hatlabs/HALPI2-hardware/CHANGES.txt

# Changes to the Covered Sources

## Introduction

As per CERN-OHL-S v2 subsection 3.3 (b), you must describe changes made to the
Covered Sources. This file is intended to be used for that purpose.

Use this file to include notices stating that you have modified the hardware
designs, giving a date and information about the modifications you have
made.

## List of Changes

- 2025-01-26: The original HALPI2 hardware design. You may replace this
  entry as it only serves as an example. [Matti Airas / Hat Labs Oy]
