hatlabs/HALPI2-hardware/(commit log)

2025-01-06 Squash history into a single commit
    [Audio.kicad_sch, CM4.kicad_sch, CM4_GPIO.kicad_sch, CM4_HS.kicad_sch, ControlRTC.kicad_sch, Ethernet.kicad_sch, PCIe.kicad_sch, PoE.kicad_sch]
2025-01-06 Weeded out all ERC errors
    [CM4_GPIO.kicad_sch, CM4_HS.kicad_sch, ControlRTC.kicad_sch, Ethernet.kicad_sch, HALPI2.kicad_sch, PCIe.kicad_sch, PoE.kicad_sch, Power.kicad_sch]
2025-01-06 Implement ideal diodes for input and LDO power ORing
    [CM4_GPIO.kicad_sch, CM4_HS.kicad_sch, HALPI2.kicad_sch, PCIe.kicad_sch, PoE.kicad_sch, Power.kicad_sch, SDCard.kicad_sch, USB.kicad_sch]
2025-01-06 Re-annotate schematics
    [CM4_GPIO.kicad_sch, CM4_HS.kicad_sch, ControlRTC.kicad_sch, Ethernet.kicad_sch, PCIe.kicad_sch, PoE.kicad_sch, Power.kicad_sch, SDCard.kicad_sch]
2025-01-06 Sprinkle test points on the schematics
    [CM4_GPIO.kicad_sch, CM4_HS.kicad_sch, ControlRTC.kicad_sch, Ethernet.kicad_sch, PCIe.kicad_sch, PoE.kicad_sch, Power.kicad_sch, SDCard.kicad_sch]
2025-01-06 Revert USB3 ports back to Type A
    [USB3.kicad_sch, rs485.kicad_sch]
2025-01-08 Fix ethernet port & other changes
    [CM4_HS.kicad_sch, Ethernet.kicad_sch, SDCard.kicad_sch, USB.kicad_sch, USB3.kicad_sch, can.kicad_sch, protection.kicad_sch]
2025-01-08 Reserve USB 2 for peripheral use only
    [USB.kicad_sch]
2025-01-10 Implement a USB3 hub
    [Audio.kicad_sch, CM4_GPIO.kicad_sch, CM4_HS.kicad_sch, ControlRTC.kicad_sch, Ethernet.kicad_sch, HALPI2.kicad_sch, PCIe.kicad_sch, PoE.kicad_sch]
2025-01-10 Finish component selection for USB3 hub
    [PoE.kicad_sch, USB3.kicad_sch, can.kicad_sch, idc.kicad_sch, pcb.kicad_sch, protection.kicad_sch, usb3_hub.kicad_sch, usb3if.kicad_sch]
2025-01-16 Partial trace layout, kick-ass custom rules
    [CM4_GPIO.kicad_sch, CM4_HS.kicad_sch, ControlRTC.kicad_sch, Ethernet.kicad_sch, HALPI2.kicad_sch, PCIe.kicad_sch, PoE.kicad_sch, Power.kicad_sch]
2025-01-16 Remove PoE support
    [Ethernet.kicad_sch, HALPI2.kicad_sch]
2025-01-18 Move to a two-sided assembly
    [Ethernet.kicad_sch, buck_10V.kicad_sch, buck_3.3V.kicad_sch, buck_5V.kicad_sch, protection.kicad_sch, supercap_stage.kicad_sch, usb3_hub.kicad_sch, usb3if.kicad_sch]
2025-01-24 A big part of layout and routing done
    [CM4_GPIO.kicad_sch, CM4_HS.kicad_sch, Ethernet.kicad_sch, HALPI2.kicad_sch, PCIe.kicad_sch, Power.kicad_sch, SDCard.kicad_sch, USB2.kicad_sch]
2025-01-26 Route more traces
    [CM4_GPIO.kicad_sch, CM4_HS.kicad_sch, Ethernet.kicad_sch, HALPI2.kicad_sch, PCIe.kicad_sch, USB2.kicad_sch, can.kicad_sch, control_mcu.kicad_sch]
2025-01-26 Update the license text and provide CHANGES.txt
    As all contents of Nabu Casa Yellow have been substituted with
    original designs or designs originating from the Raspberry Pi
    reference designs, their license notices have been removed.
2025-01-26 Fix license statements in documents
    [CM4_GPIO.kicad_sch, CM4_HS.kicad_sch, Ethernet.kicad_sch, HALPI2.kicad_sch, PCIe.kicad_sch, Power.kicad_sch, SDCard.kicad_sch, USB2.kicad_sch]
2025-01-26 Traces routed
    [CM4_GPIO.kicad_sch, Ethernet.kicad_sch, control_mcu.kicad_sch]
2025-01-26 Fix schematic ERC errors
    [CM4_GPIO.kicad_sch, CM4_HS.kicad_sch, Ethernet.kicad_sch, HALPI2.kicad_sch, PCIe.kicad_sch, Power.kicad_sch, SDCard.kicad_sch, USB2.kicad_sch]
2025-01-27 Fix footprint courtyard
2025-01-27 Renumber all sheets
    [CM4_GPIO.kicad_sch, CM4_HS.kicad_sch, Ethernet.kicad_sch, HALPI2.kicad_sch, USB2.kicad_sch, USB3.kicad_sch, can.kicad_sch, control_mcu.kicad_sch]
2025-01-27 Reannotate components
    [CM4_GPIO.kicad_sch, CM4_HS.kicad_sch, Ethernet.kicad_sch, PCIe.kicad_sch, Power.kicad_sch, SDCard.kicad_sch, USB2.kicad_sch, USB3.kicad_sch]
2025-02-02 Most DRC errors fixed
    [CM4_GPIO.kicad_sch, CM4_HS.kicad_sch, Ethernet.kicad_sch, HALPI2.kicad_sch, USB2.kicad_sch, buck_10V.kicad_sch, buck_10V_ic.kicad_sch, buck_3.3V.kicad_sch]
2025-02-06 Fix most DRC errors, partial silk screen
    [CM4_GPIO.kicad_sch, CM4_HS.kicad_sch, Ethernet.kicad_sch, USB2.kicad_sch, buck_10V.kicad_sch, can.kicad_sch, control_mcu.kicad_sch, dphy.kicad_sch]
2025-02-08 Silkscreen mostly done
    [CM4_GPIO.kicad_sch, CM4_HS.kicad_sch, Ethernet.kicad_sch, PCIe.kicad_sch, SDCard.kicad_sch, USB2.kicad_sch, USB3.kicad_sch, buck_3.3V.kicad_sch]
2025-02-15 Finish the board redesign with SoM on the bottom
    [CM4_GPIO.kicad_sch, CM4_HS.kicad_sch, Ethernet.kicad_sch, HALPI2.kicad_sch, PCIe.kicad_sch, Power.kicad_sch, SDCard.kicad_sch, USB2.kicad_sch]
2025-02-20 Further refinements
    [CM4_GPIO.kicad_sch, CM4_HS.kicad_sch, Ethernet.kicad_sch, HALPI2.kicad_sch, PCIe.kicad_sch, Power.kicad_sch, SDCard.kicad_sch, USB2.kicad_sch]
2025-02-22 Change MCU to RP2040
    [CM4_GPIO.kicad_sch, CM4_HS.kicad_sch, Ethernet.kicad_sch, HALPI2.kicad_sch, Power.kicad_sch, USB2.kicad_sch, USB3.kicad_sch, can.kicad_sch]
2025-02-24 Finish transitioning to RP2040
    [CM4_GPIO.kicad_sch, CM4_HS.kicad_sch, Ethernet.kicad_sch, HALPI2.kicad_sch, PCIe.kicad_sch, Power.kicad_sch, SDCard.kicad_sch, USB2.kicad_sch]
2025-02-24 Remove stale files
    [ldo_3.3V.kicad_sch, ldo_3v3.kicad_sch]
2025-02-25 Apply part PCBA position corrections
    [CM4_GPIO.kicad_sch, CM4_HS.kicad_sch, Ethernet.kicad_sch, Power.kicad_sch, SDCard.kicad_sch, USB2.kicad_sch, USB3.kicad_sch, buck_10V.kicad_sch]
2025-02-26 Apply teardrops, add vias around PCIe connector, update title blocks
    [CM4_GPIO.kicad_sch, CM4_HS.kicad_sch, Ethernet.kicad_sch, HALPI2.kicad_sch, PCIe.kicad_sch, Power.kicad_sch, SDCard.kicad_sch, USB2.kicad_sch]
2025-03-26 Fix battery connector polarity
2025-03-26 Use new supplier enclosure outline
    [pcb.kicad_sch]
2025-03-26 Increase USB3 nEN pulldown resistor size
    [usb3if.kicad_sch]
2025-03-26 Re-add test fixture annotations to layout
    [CM4_GPIO.kicad_sch, CM4_HS.kicad_sch, Ethernet.kicad_sch, USB2.kicad_sch, can.kicad_sch, control_mcu.kicad_sch, rs485.kicad_sch, rtc.kicad_sch]
2025-04-01 Update the design to match the enclosure changes
    [CM4_GPIO.kicad_sch, CM4_HS.kicad_sch, Ethernet.kicad_sch, HALPI2.kicad_sch, PCIe.kicad_sch, Power.kicad_sch, SDCard.kicad_sch, USB2.kicad_sch]
2025-04-01 Update CM connector part number
    [CM4_GPIO.kicad_sch, CM4_HS.kicad_sch]
2025-04-01 Add comments about diff pair polarity
    [PCIe.kicad_sch, dphy.kicad_sch, hdmi.kicad_sch, usb3_hub.kicad_sch]
2025-04-02 Update SiC462 datasheet
    [CM4_GPIO.kicad_sch, CM4_HS.kicad_sch, Ethernet.kicad_sch, USB2.kicad_sch, buck_10V_ic.kicad_sch, can.kicad_sch, control_mcu.kicad_sch, rs485.kicad_sch]
2025-04-04 Update buck components according to testing results
    [buck_10V_ic.kicad_sch]
2025-04-04 Update current limiter components
    [current_limiter.kicad_sch]
2025-04-04 Implement overvoltage disconnect
    [protection.kicad_sch]
2025-04-10 Get the buck EN input from VIN_OVP
    [buck_10V.kicad_sch, buck_10V_ic.kicad_sch]
2025-04-10 Update CAN transceiver value to match the used parts; connect VIO
    [can.kicad_sch]
2025-04-10 Remove CM4 fan provisions
    [CM4_GPIO.kicad_sch]
2025-04-10 Replace DPHY selector jumper with a slide switch
    [CM4_HS.kicad_sch]
2025-04-10 Reorder MCU inputs to help routing on the board top side
    [control_mcu.kicad_sch]
2025-04-10 Fix DPHY pinout
    [dphy.kicad_sch]
2025-04-10 Try to improve current limiter stability
    [current_limiter.kicad_sch]
2025-04-10 Remove Molex fan connector, add another CM5 connector to board bottom
    [fan_connectors.kicad_sch]
2025-04-10 Fix HDMI pinout
    [hdmi.kicad_sch]
2025-04-10 Move battery holder footprint to global library
2025-04-10 Fixme VIN_OVP
    [Power.kicad_sch]
2025-04-10 Use LM74800 for input protection
    [protection.kicad_sch]
2025-04-10 Remove the CM4 RTC IC
    [control_mcu.kicad_sch, rtc.kicad_sch]
2025-04-10 Reannotate the board
    [CM4_GPIO.kicad_sch, CM4_HS.kicad_sch, Ethernet.kicad_sch, HALPI2.kicad_sch, PCIe.kicad_sch, SDCard.kicad_sch, USB2.kicad_sch, USB3.kicad_sch]
2025-04-13 Fix DRC issues
    [CM4_GPIO.kicad_sch, CM4_HS.kicad_sch, Ethernet.kicad_sch, PCIe.kicad_sch, Power.kicad_sch, SDCard.kicad_sch, USB2.kicad_sch, USB3.kicad_sch]
2025-04-15 Add GND/3.3V/5V headers, add missing JLC part numbers
    [CM4_GPIO.kicad_sch, CM4_HS.kicad_sch, Ethernet.kicad_sch, buck_10V.kicad_sch, buck_10V_ic.kicad_sch, buck_3.3V.kicad_sch, buck_5V.kicad_sch, can.kicad_sch]
2025-04-15 Adjust Micro-USB 5V LDO layout
    Diode before LDO, not after
    [control_mcu.kicad_sch]
2025-04-15 Adjust 10V buck design based on Vishay tool output
    [HALPI2.kicad_sch, Power.kicad_sch, buck_10V.kicad_sch, buck_10V_ic.kicad_sch, control_mcu.kicad_sch]
2025-04-25 FInal v0.2.0 proto changes
    [CM4_GPIO.kicad_sch, CM4_HS.kicad_sch, Ethernet.kicad_sch, PCIe.kicad_sch, SDCard.kicad_sch, USB2.kicad_sch, USB3.kicad_sch, buck_10V.kicad_sch]
2025-04-25 Add reverse current blocking to 3.3V buck output
    [CM4_GPIO.kicad_sch, CM4_HS.kicad_sch, Ethernet.kicad_sch, PCIe.kicad_sch, Power.kicad_sch, SDCard.kicad_sch, USB2.kicad_sch, USB3.kicad_sch]
2025-05-01 Fix HDMI and DSI pinouts, again
    Also add the missing LM74800 diode
    [CM4_GPIO.kicad_sch, CM4_HS.kicad_sch, Ethernet.kicad_sch, USB2.kicad_sch, can.kicad_sch, control_mcu.kicad_sch, protection.kicad_sch, rs485.kicad_sch]
2025-05-06 Nailed the current limiter design
    Also added more GND test pads
    Also fixed the MCU I2C pinout
    [CM4_GPIO.kicad_sch, CM4_HS.kicad_sch, Ethernet.kicad_sch, PCIe.kicad_sch, Power.kicad_sch, SDCard.kicad_sch, USB2.kicad_sch, USB3.kicad_sch]
2025-05-06 Add a THT testpoint for Vscap
    [CM4_GPIO.kicad_sch, CM4_HS.kicad_sch, Ethernet.kicad_sch, USB2.kicad_sch, can.kicad_sch, control_mcu.kicad_sch, dphy.kicad_sch, rs485.kicad_sch]
2025-05-07 Optimize 10V buck converter based on testing
    [buck_10V_ic.kicad_sch, current_limiter.kicad_sch]
2025-05-07 Remove unnecessary pullup
    [buck_3.3V.kicad_sch]
2025-05-07 Connect PCIe LED to MCU
    [CM4_GPIO.kicad_sch, CM4_HS.kicad_sch, Ethernet.kicad_sch, HALPI2.kicad_sch, PCIe.kicad_sch, USB2.kicad_sch, can.kicad_sch, control_mcu.kicad_sch]
2025-05-08 Final chores
    - Reannotate components
    - Improve USB2 connector skew matching
    - Update sheet blocks
    - Fix some diff-pair double-inversions
    [CM4_GPIO.kicad_sch, CM4_HS.kicad_sch, Ethernet.kicad_sch, HALPI2.kicad_sch, PCIe.kicad_sch, Power.kicad_sch, SDCard.kicad_sch, USB2.kicad_sch]
2025-05-08 Add some missing LCSC P/Ns
    [CM4_GPIO.kicad_sch, CM4_HS.kicad_sch, Ethernet.kicad_sch, PCIe.kicad_sch, Power.kicad_sch, SDCard.kicad_sch, USB2.kicad_sch, USB3.kicad_sch]
2025-05-08 Add some vias to appease breakneck
    [CM4_GPIO.kicad_sch, CM4_HS.kicad_sch, Ethernet.kicad_sch, PCIe.kicad_sch, Power.kicad_sch, SDCard.kicad_sch, USB2.kicad_sch, USB3.kicad_sch]
2025-06-05 Fix DSI/CSI connector orientation
2025-06-06 Move DPHY conx on top of the CM5
    [CM4_GPIO.kicad_sch, CM4_HS.kicad_sch, Ethernet.kicad_sch, PCIe.kicad_sch, Power.kicad_sch, SDCard.kicad_sch, USB2.kicad_sch, USB3.kicad_sch]
2025-06-06 Bump version, adjust silkscreen
    [CM4_GPIO.kicad_sch, CM4_HS.kicad_sch, Ethernet.kicad_sch, HALPI2.kicad_sch, PCIe.kicad_sch, Power.kicad_sch, SDCard.kicad_sch, USB2.kicad_sch]
2025-06-06 Prepare v0.4.0 release
    [CM4_GPIO.kicad_sch, CM4_HS.kicad_sch, Ethernet.kicad_sch, USB2.kicad_sch, buck_3.3V.kicad_sch, can.kicad_sch, control_mcu.kicad_sch, dphy.kicad_sch]
2025-06-09 Improve 10V buck stability
    Also use a different net for Iin ADC input, add a 3.3V UVLO and
    a slow reset for the MCU.
    [CM4_GPIO.kicad_sch, CM4_HS.kicad_sch, Ethernet.kicad_sch, HALPI2.kicad_sch, PCIe.kicad_sch, Power.kicad_sch, SDCard.kicad_sch, USB2.kicad_sch]
2025-06-18 Increase RP2040 decoupling capacitance
    [CM4_GPIO.kicad_sch, CM4_HS.kicad_sch, Ethernet.kicad_sch, USB2.kicad_sch, buck_3.3V.kicad_sch, can.kicad_sch, control_mcu.kicad_sch, dphy.kicad_sch]
2025-06-26 Silkscreen fix
2025-06-26 Use SPI legacy pin names
    SDI and SDO were ambiguous.
    [CM4_GPIO.kicad_sch, CM4_HS.kicad_sch, Ethernet.kicad_sch, PCIe.kicad_sch, Power.kicad_sch, SDCard.kicad_sch, USB2.kicad_sch, USB3.kicad_sch]
2025-07-03 Remove copper pour from bottom layer next to mounting structures
2025-07-03 Fix 3.3V buck UVLO top resistor
    [CM4_GPIO.kicad_sch, CM4_HS.kicad_sch, Ethernet.kicad_sch, USB2.kicad_sch, buck_3.3V.kicad_sch, can.kicad_sch, control_mcu.kicad_sch, dphy.kicad_sch]
2025-07-03 Remove THTs from HAT outline footprint
2025-07-03 Add solder nuts to schema
    [pcb.kicad_sch]
2025-07-28 Change two-pin headers back to THT for mechanical durability
    Also fix a silk screen issue and move the 3.3V off header to a better
    position.
    [CM4_GPIO.kicad_sch, CM4_HS.kicad_sch, Ethernet.kicad_sch, USB2.kicad_sch, can.kicad_sch, control_mcu.kicad_sch, current_limiter.kicad_sch, dphy.kicad_sch]
2025-07-30 Add solder nuts to CM5 mounting holes
    Also revert two-pin headers back to THT type for better mechanical
    durability. Remove unused symbol fields. Move the 3.3V off pin to
    a more accessible location.
    [CM4_GPIO.kicad_sch, CM4_HS.kicad_sch, Ethernet.kicad_sch, PCIe.kicad_sch, Power.kicad_sch, SDCard.kicad_sch, USB2.kicad_sch, USB3.kicad_sch]
2025-08-03 Derive VinS from VIN_OVP
    Some extra care needed for routing due to a split ground.
    [HALPI2.kicad_sch, Power.kicad_sch, control_mcu.kicad_sch]
2025-08-09 Decrease Iin ADC series resistor to 1kohm
    [control_mcu.kicad_sch]
2025-08-09 Bump the board version
    [CM4_GPIO.kicad_sch, CM4_HS.kicad_sch, Ethernet.kicad_sch, HALPI2.kicad_sch, PCIe.kicad_sch, Power.kicad_sch, SDCard.kicad_sch, USB2.kicad_sch]
2025-08-12 WIP supercap balancer
    [supercap_stage.kicad_sch]
2025-08-12 Also derive VscapE from 3.3V early LDO
    [early_3v3.kicad_sch]
2025-08-12 Add a +5V LED
    [mcu_leds.kicad_sch]
2025-08-12 Adjust the supercap balancer components
    The opamps are now powered using VscapE
    [Power.kicad_sch, supercap.kicad_sch, supercap_stage.kicad_sch]
2025-08-13 Belt and suspenders: add a pull-down resistor footprint to balancer op-amp output
    [HALPI2.kicad_sch, supercap_stage.kicad_sch]
2025-08-13 Reorganize the forced power and MCU boot headers
    [HALPI2.kicad_sch, Power.kicad_sch, buck_3.3V.kicad_sch, buck_5V.kicad_sch, control_mcu.kicad_sch]
2025-08-15 Bump the title block date
    [CM4_GPIO.kicad_sch, CM4_HS.kicad_sch, Ethernet.kicad_sch, HALPI2.kicad_sch, PCIe.kicad_sch, Power.kicad_sch, SDCard.kicad_sch, USB2.kicad_sch]
2025-08-15 Add missing part codes
    [control_mcu.kicad_sch, supercap_stage.kicad_sch]
2025-08-15 Add missing JLCPCB orientation correction fields
    [can.kicad_sch, control_mcu.kicad_sch, rs485.kicad_sch]
2025-08-18 Change the 10V buck to SiC563
    [buck_10V_ic.kicad_sch]
2025-08-24 Move the RGB led footprints to the HL library
    [rgb_leds.kicad_sch]
2025-08-26 Adjust the boot mode switch test pad
    Also provide labels for some unnamed nets.
    [CM4_GPIO.kicad_sch, can.kicad_sch, rs485.kicad_sch]
2025-08-27 Fix component placement correction
    [can.kicad_sch, control_mcu.kicad_sch, rs485.kicad_sch]
2025-09-10 Add an SD PWR test point
    [SDCard.kicad_sch, hdmi.kicad_sch]
2025-09-20 Add a datasheet link for the FFC connectors
    [hdmi.kicad_sch]
2025-10-06 Re-route fast interfaces; split 3.3V to permanent and controller parts
    [CM4_HS.kicad_sch, Ethernet.kicad_sch, HALPI2.kicad_sch, PCIe.kicad_sch, Power.kicad_sch, buck_10V.kicad_sch, buck_10V_ic.kicad_sch, buck_3.3V.kicad_sch]
2025-10-07 Improve 10V buck converter stability
    [CM4_GPIO.kicad_sch, CM4_HS.kicad_sch, Ethernet.kicad_sch, HALPI2.kicad_sch, PCIe.kicad_sch, Power.kicad_sch, SDCard.kicad_sch, USB2.kicad_sch]
2025-10-08 Fix board edge continuity
2025-10-09 Reimplement supercap balancer with a single 4-unit op amp IC
    [supercap.kicad_sch, supercap_stage.kicad_sch]
2025-10-13 Change FLASH footprint and some components for availability
    [SDCard.kicad_sch, control_mcu.kicad_sch, hdmi.kicad_sch, supercap_stage.kicad_sch, usb3_hub.kicad_sch, usb3if.kicad_sch]
2025-10-14 Fix component part numbers
    [buck_3.3V.kicad_sch, control_mcu.kicad_sch, supercap_stage.kicad_sch, usb3if.kicad_sch]
2025-12-05 Add the missing capacitors to the USB3 hub RX diff pairs
    Also adjust RS485 auto-enable resistor sizes and remove the
    extra USB3-0 diff pair caps
    [USB3.kicad_sch, rs485.kicad_sch, usb3_hub.kicad_sch, usb3if-0.kicad_sch]
2025-12-11 Provide grounding at every mounting point
    Also relabel RS-485 pins
    [pcb.kicad_sch]
2025-12-11 Add a clock oscillator for NVMe SUSCLK
    [PCIe.kicad_sch, mcu_leds.kicad_sch]
2025-12-20 Bump board revision to 0.6.1.
    Adjust M.2 connector SUSCLK direction.
    [CM4_GPIO.kicad_sch, CM4_HS.kicad_sch, Ethernet.kicad_sch, HALPI2.kicad_sch, PCIe.kicad_sch, Power.kicad_sch, SDCard.kicad_sch, USB2.kicad_sch]
2026-01-13 Update JLCPCB corrections
    [PCIe.kicad_sch, SDCard.kicad_sch, buck_3.3V.kicad_sch, hdmi.kicad_sch, mcu_leds.kicad_sch, supercap.kicad_sch, supercap_stage.kicad_sch]
2026-02-02 Increase the SUSCLK oscillator C1 cap value
    [PCIe.kicad_sch]
2026-02-21 Fix v0.6.1 RS-485 issues
    - Add a pulldown to ~{EN}
    - Change ~{EN} to GPIO15
    - Add pull-ups and pull-downs to TX pins
    [CM4_GPIO.kicad_sch, PCIe.kicad_sch, rs485.kicad_sch]
2026-03-23 Change RS-485 ~EN pulldown to 100k
    A weak pulldown is enough.
    [rs485.kicad_sch]
2026-06-12 feat(can): add R154 pull-up on CAN CS line
    Add a 10k pull-up (R154, 0402) on the CAN controller chip-select net so
    CS stays deasserted while the SPI host is uninitialised.
    Opening the project in KiCad 10 re-serialised every schematic and the
    PCB (generator_version 9.0 -> 10.0); that format churn is the bulk of
    this diff. R154 is the only functional change.
    [CM4_GPIO.kicad_sch, CM4_HS.kicad_sch, Ethernet.kicad_sch, HALPI2.kicad_sch, PCIe.kicad_sch, Power.kicad_sch, SDCard.kicad_sch, USB2.kicad_sch]
