hatlabs/HALPI2-hardware/(notices)

Notices in the files:
idc.kicad_sch:
HALPI2 is licensed under CERN-OHL-S v2.
PoE.kicad_sch:
https://creativecommons.org/licenses/by/4.0
HALPI2 is licensed under CC BY 4.0.
